Guglielmenzo/ism-sdr-board/hardware/datasheets/README.md

# Datasheets

| Part | Role | File | Reference circuit |
|---|---|---|---|
| Qorvo QPL9547 | LNA | [PDF](Qorvo_QPL9547_LNA.pdf) | [EVB schematic, p. 4](reference-circuits/README.md#qorvo-qpl9547-lna) |
| Qorvo TQP3M9037 | Alternate LNA (same footprint) | [PDF](Qorvo_TQP3M9037_LNA.pdf) | [EVB schematic, p. 5](reference-circuits/README.md#qorvo-tqp3m9037-alternate-lna) |
| Abracon AFS20A26-915.00 | 915 MHz SAW filter | [PDF](Abracon_AFS20A26-915.00_SAW-915MHz.pdf) | [Land pattern and measurement circuit, p. 5](reference-circuits/README.md#abracon-afs20a26-91500-saw-filter) |
| Abracon AFII-SW-0091 | Smaller SAW alternative | [PDF](Abracon_AFII-SW-0091_SAW-915MHz.pdf) | — |
| ADI ADL5380 | I/Q demodulator | [PDF](ADI_ADL5380_IQ-demodulator.pdf) | [Figure 78, p. 23](reference-circuits/README.md#adi-adl5380-iq-demodulator) |

## Still to add

| Part | Role | Where to get it |
|---|---|---|
| ADI ADF4351 | LO synthesizer | [analog.com product page](https://www.analog.com/en/products/adf4351.html) |
| ST STM32F072CBT6 | Controller | st.com, STM32F072CB product page (data sheet and the STM32F0 hardware getting-started note) |
| Mini-Circuits TC1-1-13M+ | RF and LO baluns | [minicircuits.com PDF](https://www.minicircuits.com/pdfs/TC1-1-13M+.pdf) |
| ADI ADA4807-2 | Baseband op-amps | analog.com product page |
| TI TPS7A20 | Low-noise LO LDO | ti.com product page |
| ST USBLC6-2SC6 | USB ESD | st.com product page |
| GCT USB4105-GF-A | USB-C with data | gct.co product page |
| 25 MHz TCXO | LO reference | Once a part is chosen |
