Guglielmenzo/ism-sdr-board/notebooks/80KHz_3rdOrder_LPF.png

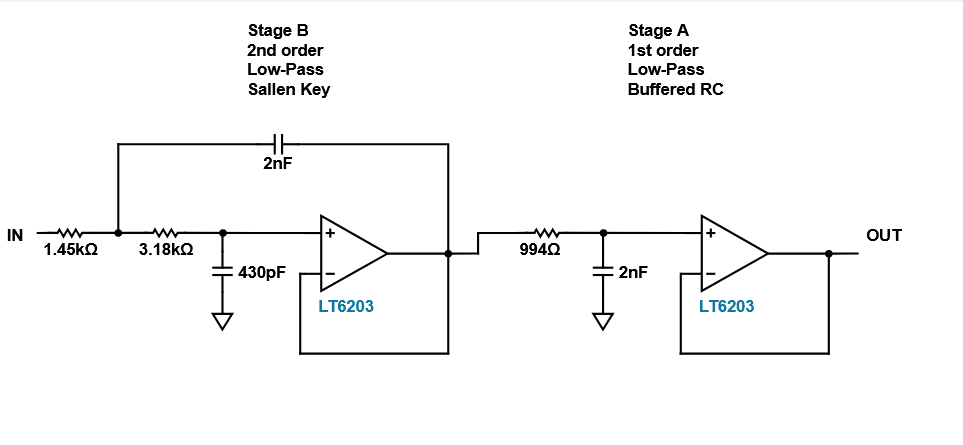
notebooks/80KHz_3rdOrder_LPF.png
