Guglielmenzo/ism-sdr-board/docs/SDR_FirstRound_Schematic.pdf

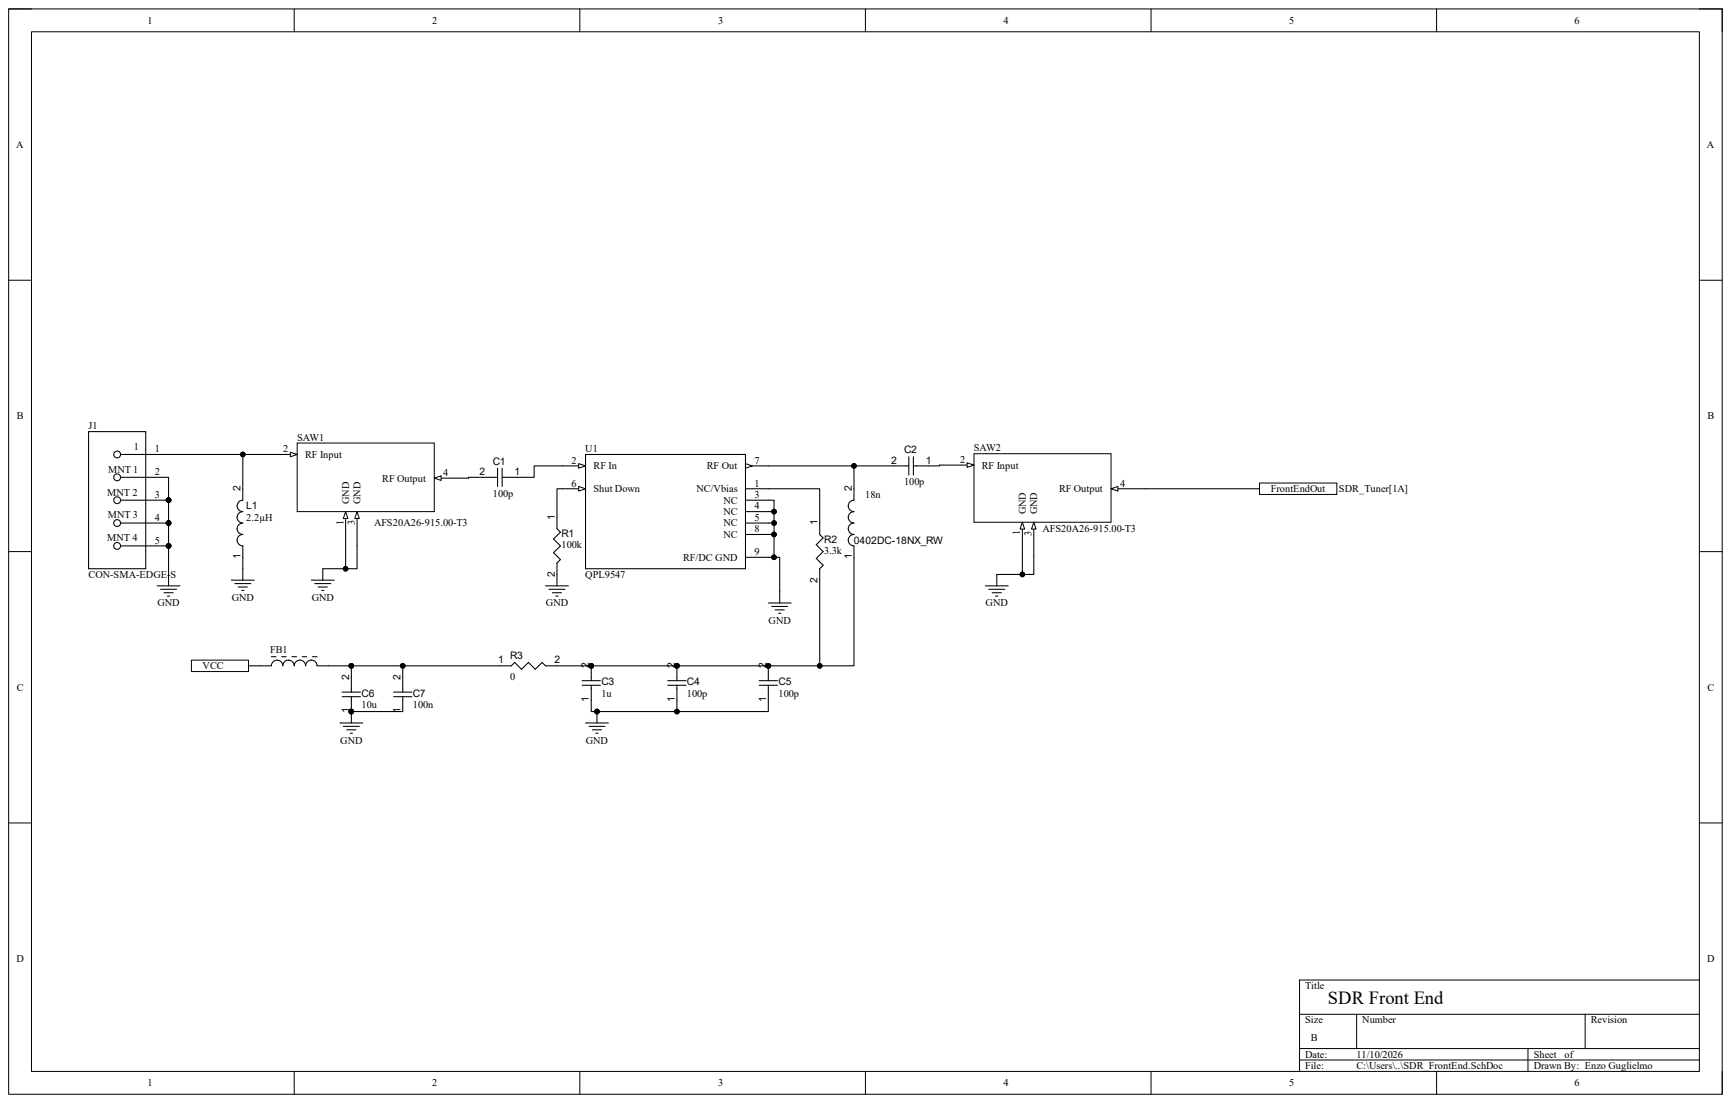
[picture p8: page 1]

C9 2 1

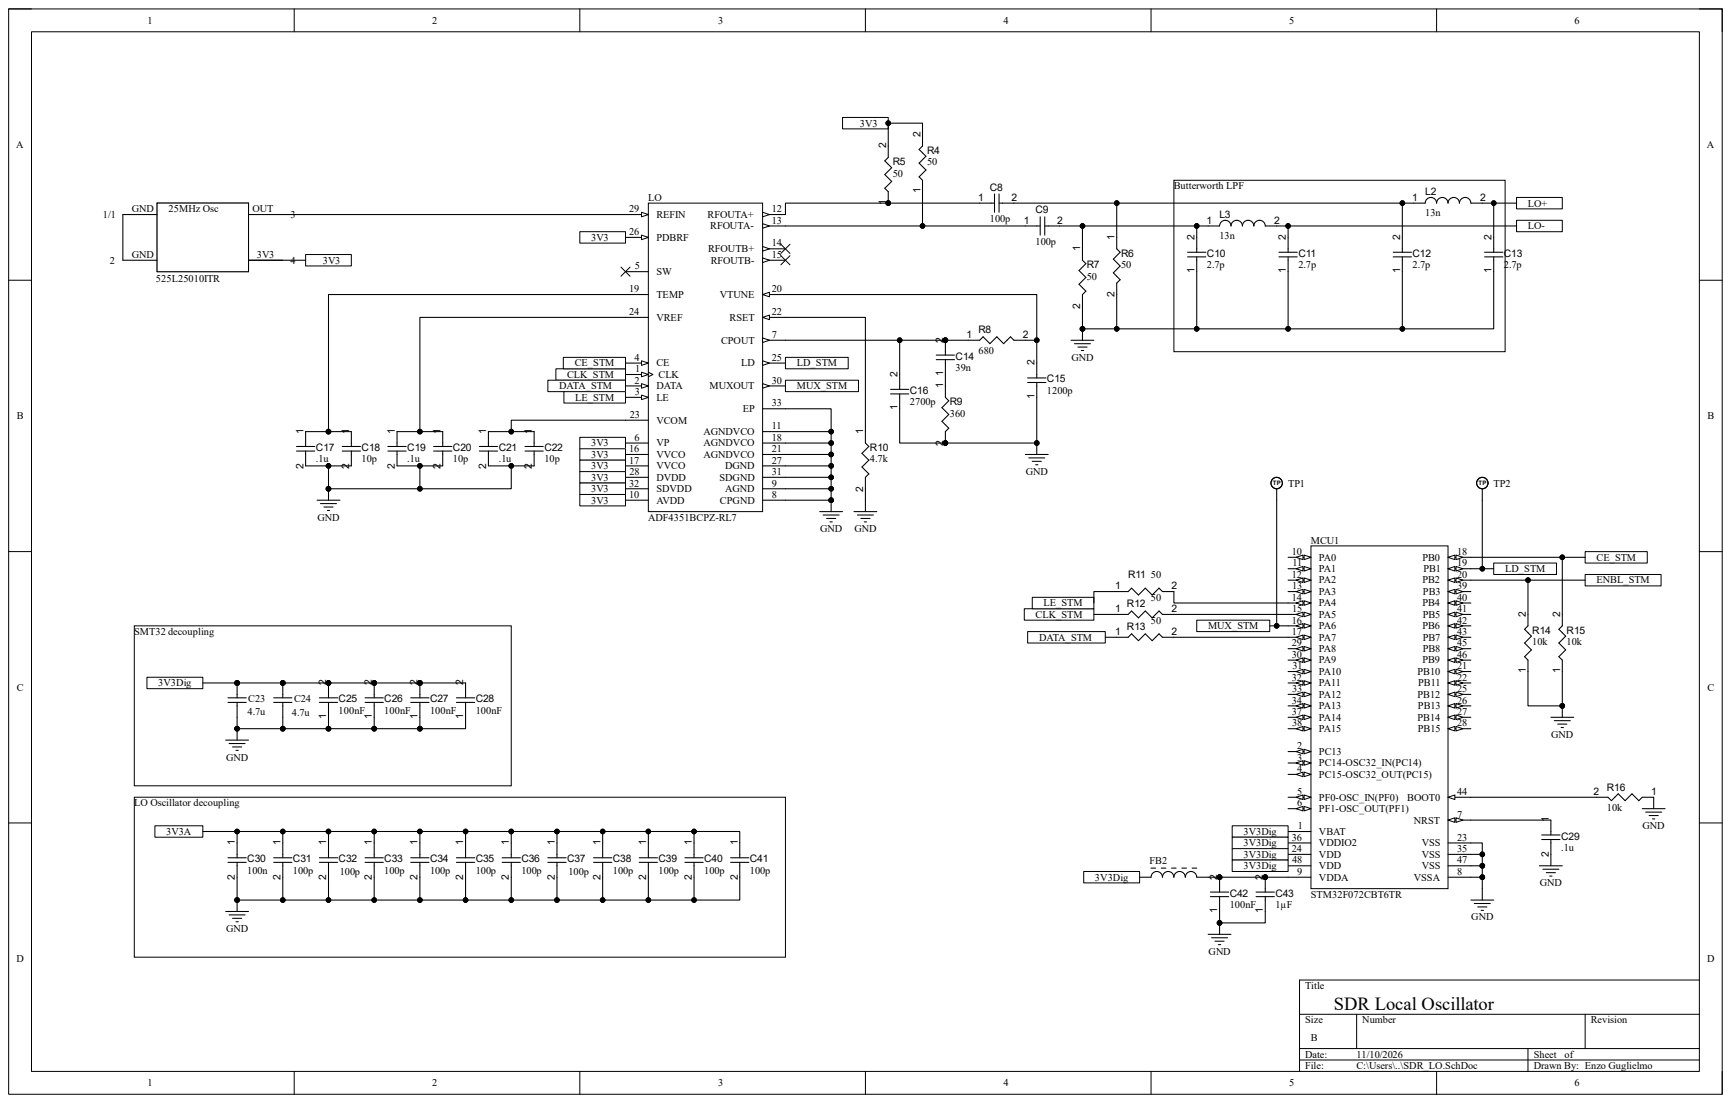
[picture p9: page 2]

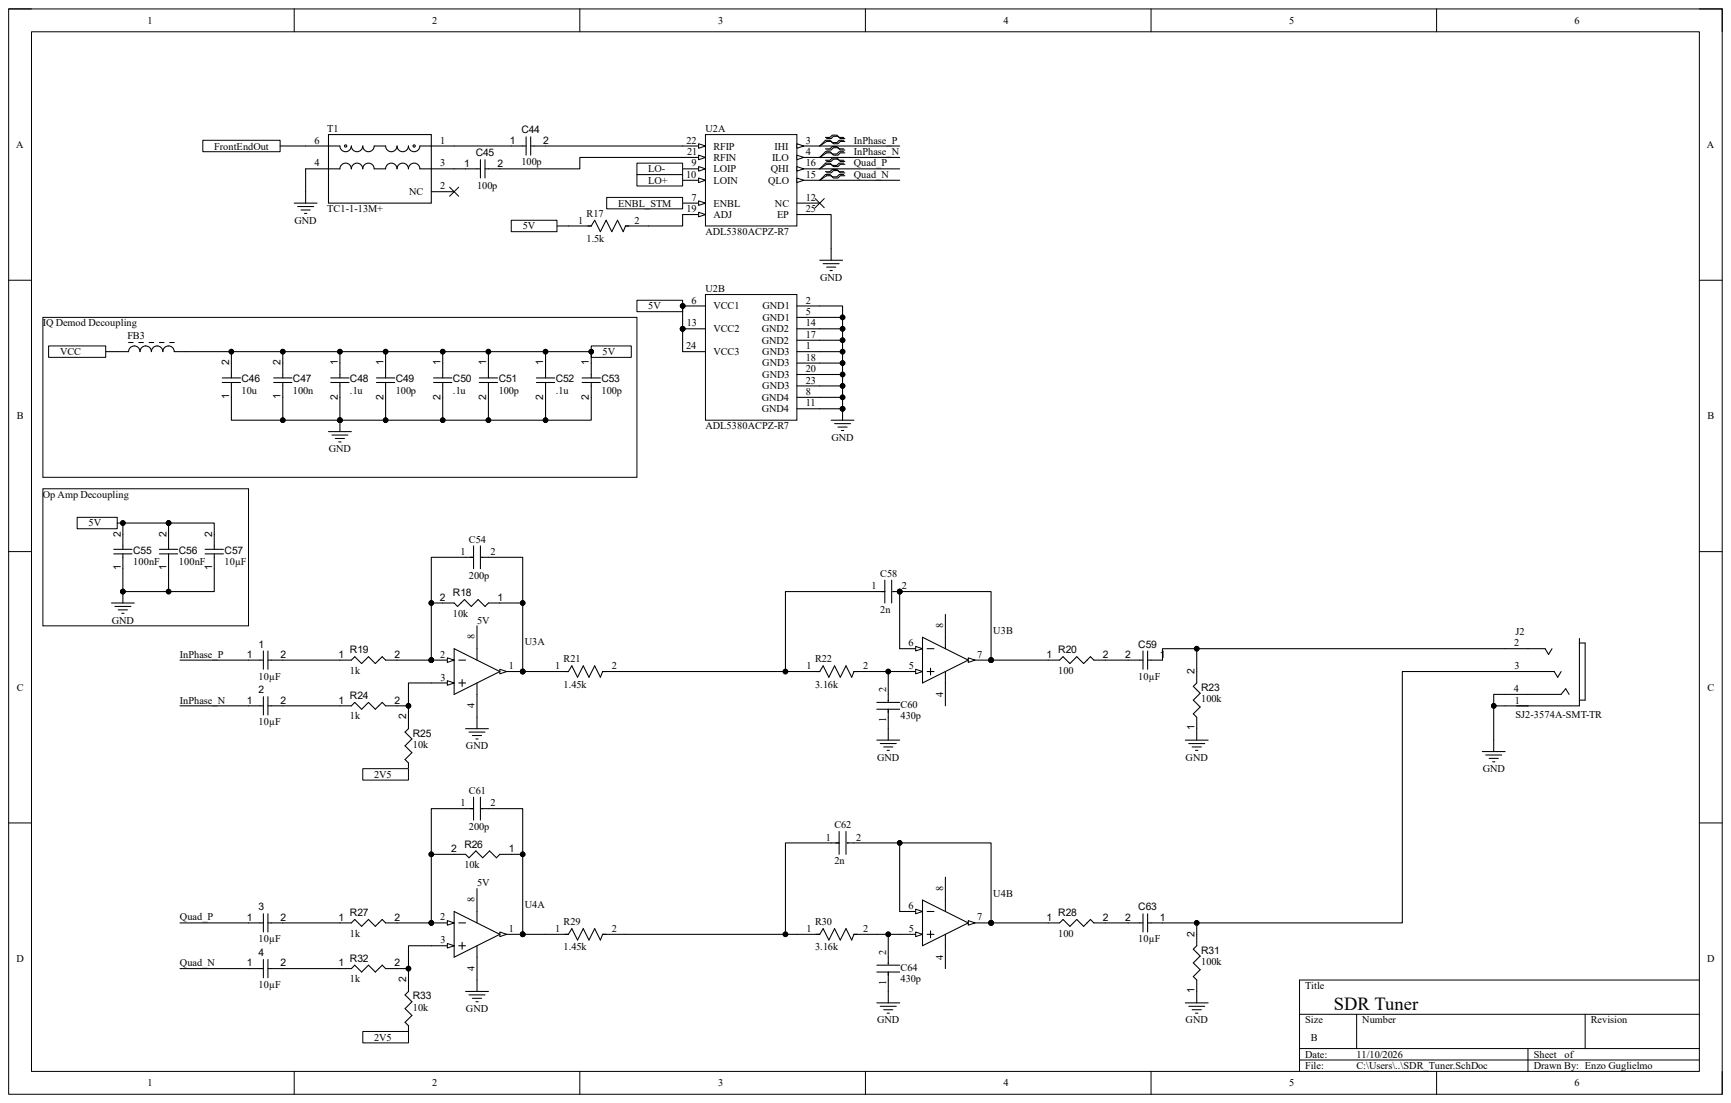
[picture p10: page 3]

R34 1

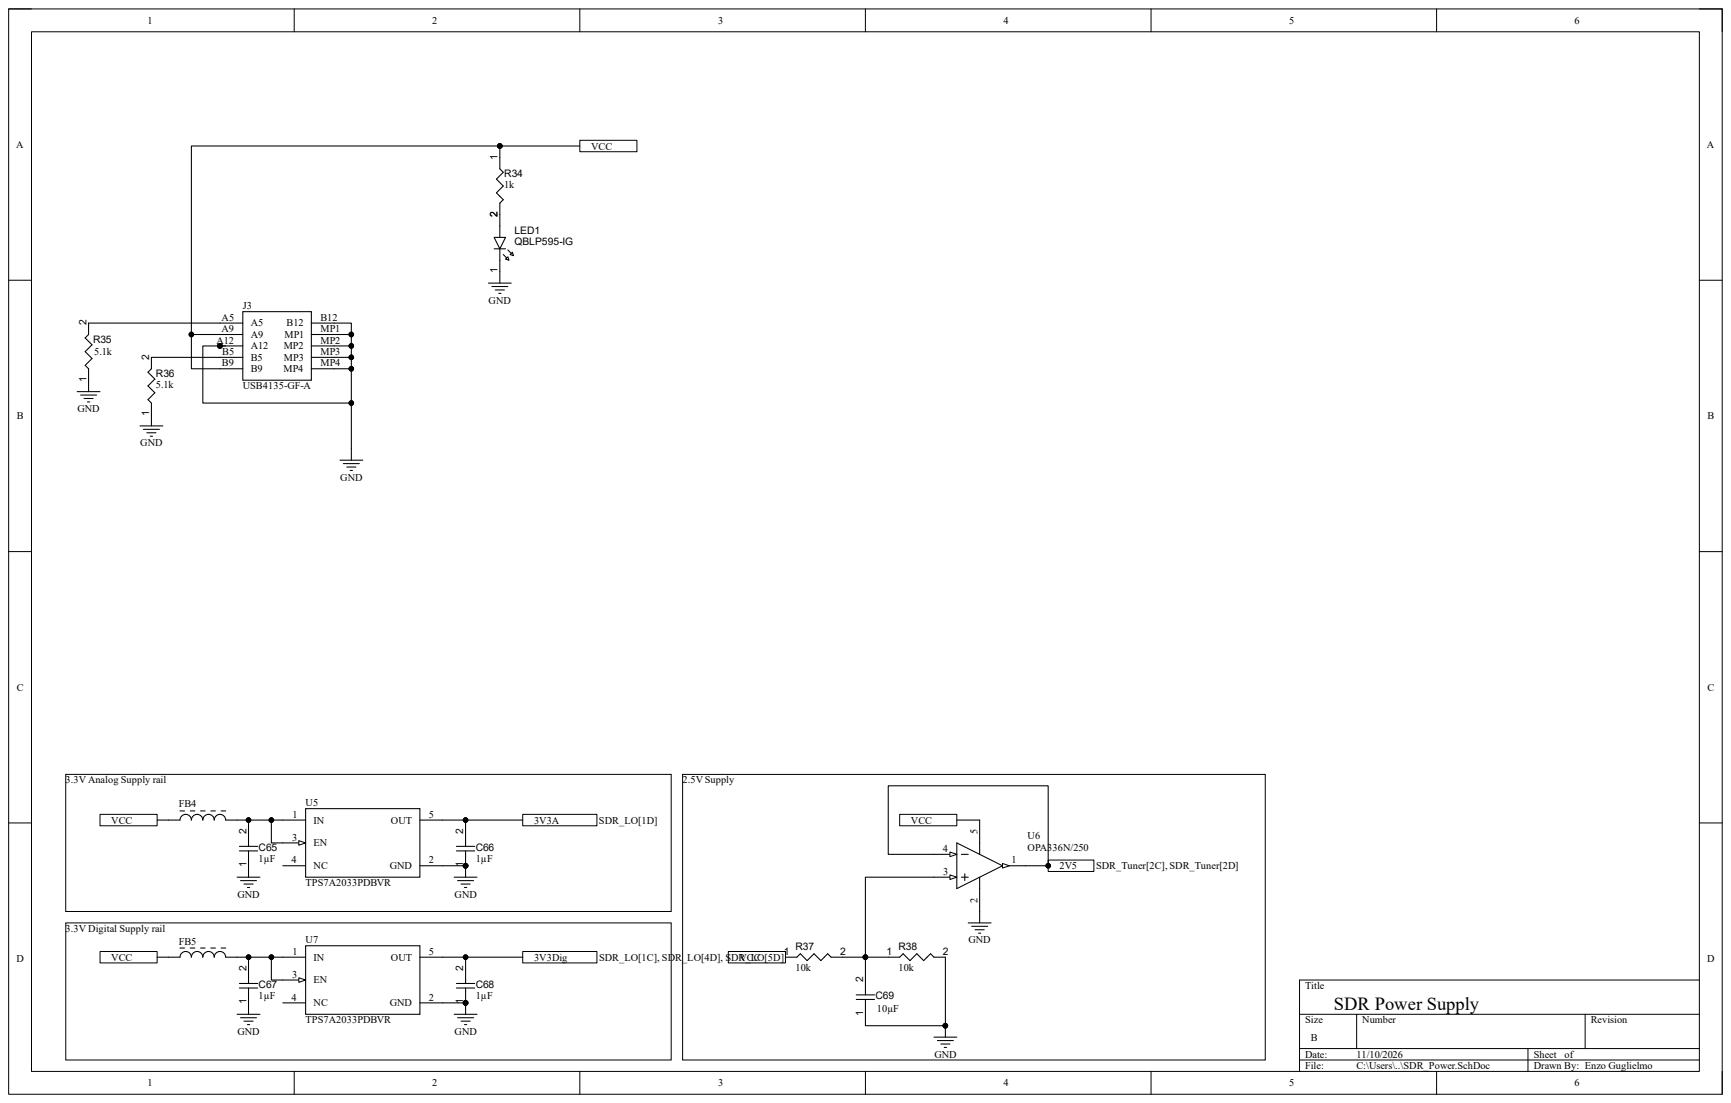
[picture p11: page 4]
