Guglielmenzo/ism-sdr-board/(list of files, drawings)

Other design files:
ISM_SDR_PCB/ISM_SDR_PCB.PrjPcb
ISM_SDR_PCB/SDR_FrontEnd.SchDoc
ISM_SDR_PCB/SDR_LO.SchDoc
ISM_SDR_PCB/SDR_PCB.PcbDoc
ISM_SDR_PCB/SDR_Power.SchDoc
ISM_SDR_PCB/SDR_Tuner.SchDoc
