Guglielmenzo/ism-sdr-board/(commit log)

2026-10-28 Initial import of ISM-band SDR board docs and specs
    Front-end, tuner and power sheet specs, design log, datasheets,
    README, CLAUDE.md, pyproject and a .gitignore for Altium output.
2026-10-28 Restructure as a GitHub project with README and reference circuits
    - README.md as the GitHub front page: overview, targets, main parts, layout
    - docs/architecture.md and docs/roadmap.md split out of the old notes
    - hardware/README.md index of the sheet specs
    - hardware/datasheets/README.md: datasheet index and the ones still to add
    - hardware/datasheets/reference-circuits: the manufacturer circuits each
    section copies, with page images and the TC1-1-13M+ pinout
    - README-ism-sdr-board.md reduced to a vault stub pointing at README.md
2026-11-09 added landing read me
2026-11-11 Schematic PDF added
2026-11-11 Added the sdr schematic Files
2026-11-11 Updated ReadMe to direct to pcb files
2026-11-13 More progress on schematic
